luney112/touch-controller-v2/README.md

# touch-controller-v2

Version 2 of my touch controller for chunithm.

## TODO

- [ ] Finish firmware
- [ ] Test fully
- [ ] Write out docs and assembly instructions
