luney112/touch-controller-v2/cad/bambu.3mf

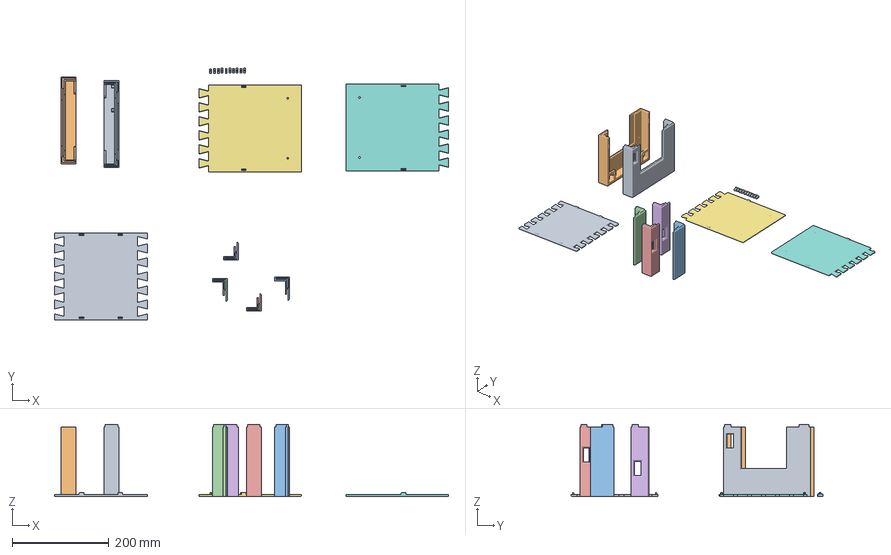
[picture p1: CAD file, 2025-06-15]
cad/bambu.3mf
815.8 x 521.4 x 149.2 mm
ShellRight
ShellLeft
ShellBottomCenterLeft
ShellBottomCenterRight
ShellTopCenterRight
ShellTopCenterLeft
BackPlateLeft
BackPlateRight
BackPlateCenter
LeftHold x 5
RightHold x 5
