luney112/touch-controller-v2/lasercut/glass.dxf

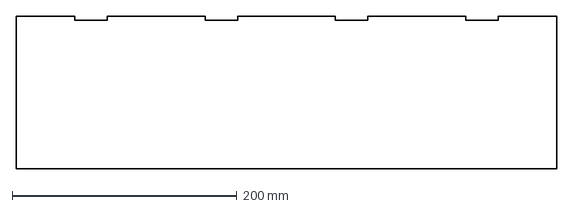
[picture p2: CAD file, 2025-06-01]
lasercut/glass.dxf
481.0 x 136.0 mm
