luney112/touch-controller-v2/cad/Controller3 v68.3mf

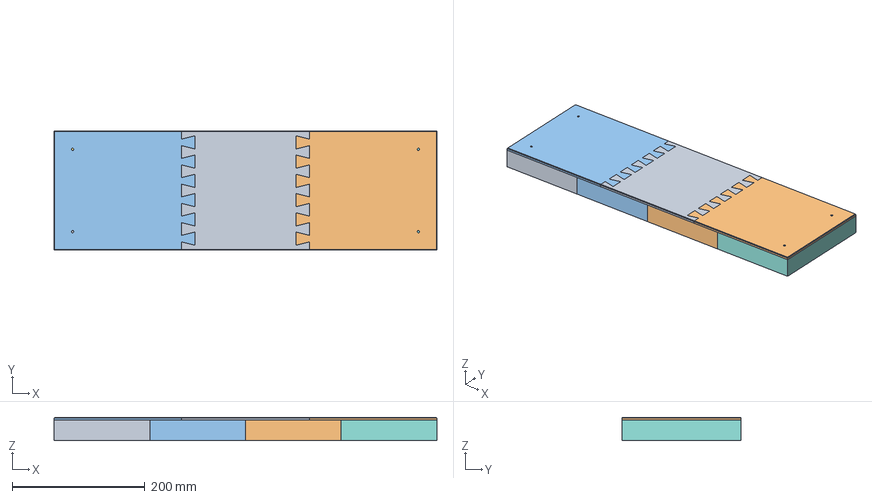
[picture p3: CAD file, 2025-06-14]
cad/Controller3 v68.3mf
577.0 x 180.0 x 35.0 mm
BackPlateCenter
BackPlateLeft
BackPlateRight
FrontGlass
KeysLeft
KeysRight
LeftHold
Mainboard
PcbLeft
PcbLeftCenter
PcbRight
PcbRightCenter
RightHold
Sensor
ShellBottomCenterLeft
ShellBottomCenterRight
ShellLeft
ShellRight
ShellTopCenterLeft
ShellTopCenterRight
