luney112/touch-controller-v2/lasercut/keys.dxf

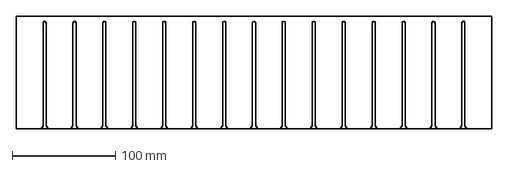
[picture p4: CAD file, 2025-06-01]
lasercut/keys.dxf
461.0 x 109.0 mm
