luney112/touch-controller-v2/(list of files, cad)

Other CAD files:
cad/Controller3 v68.f3d
