luney112/touch-controller-v2/kicad/touch-pads/touch-pads.kicad_pcb

## KiCad design kicad/touch-pads/touch-pads.kicad_pcb (2025-05-29)

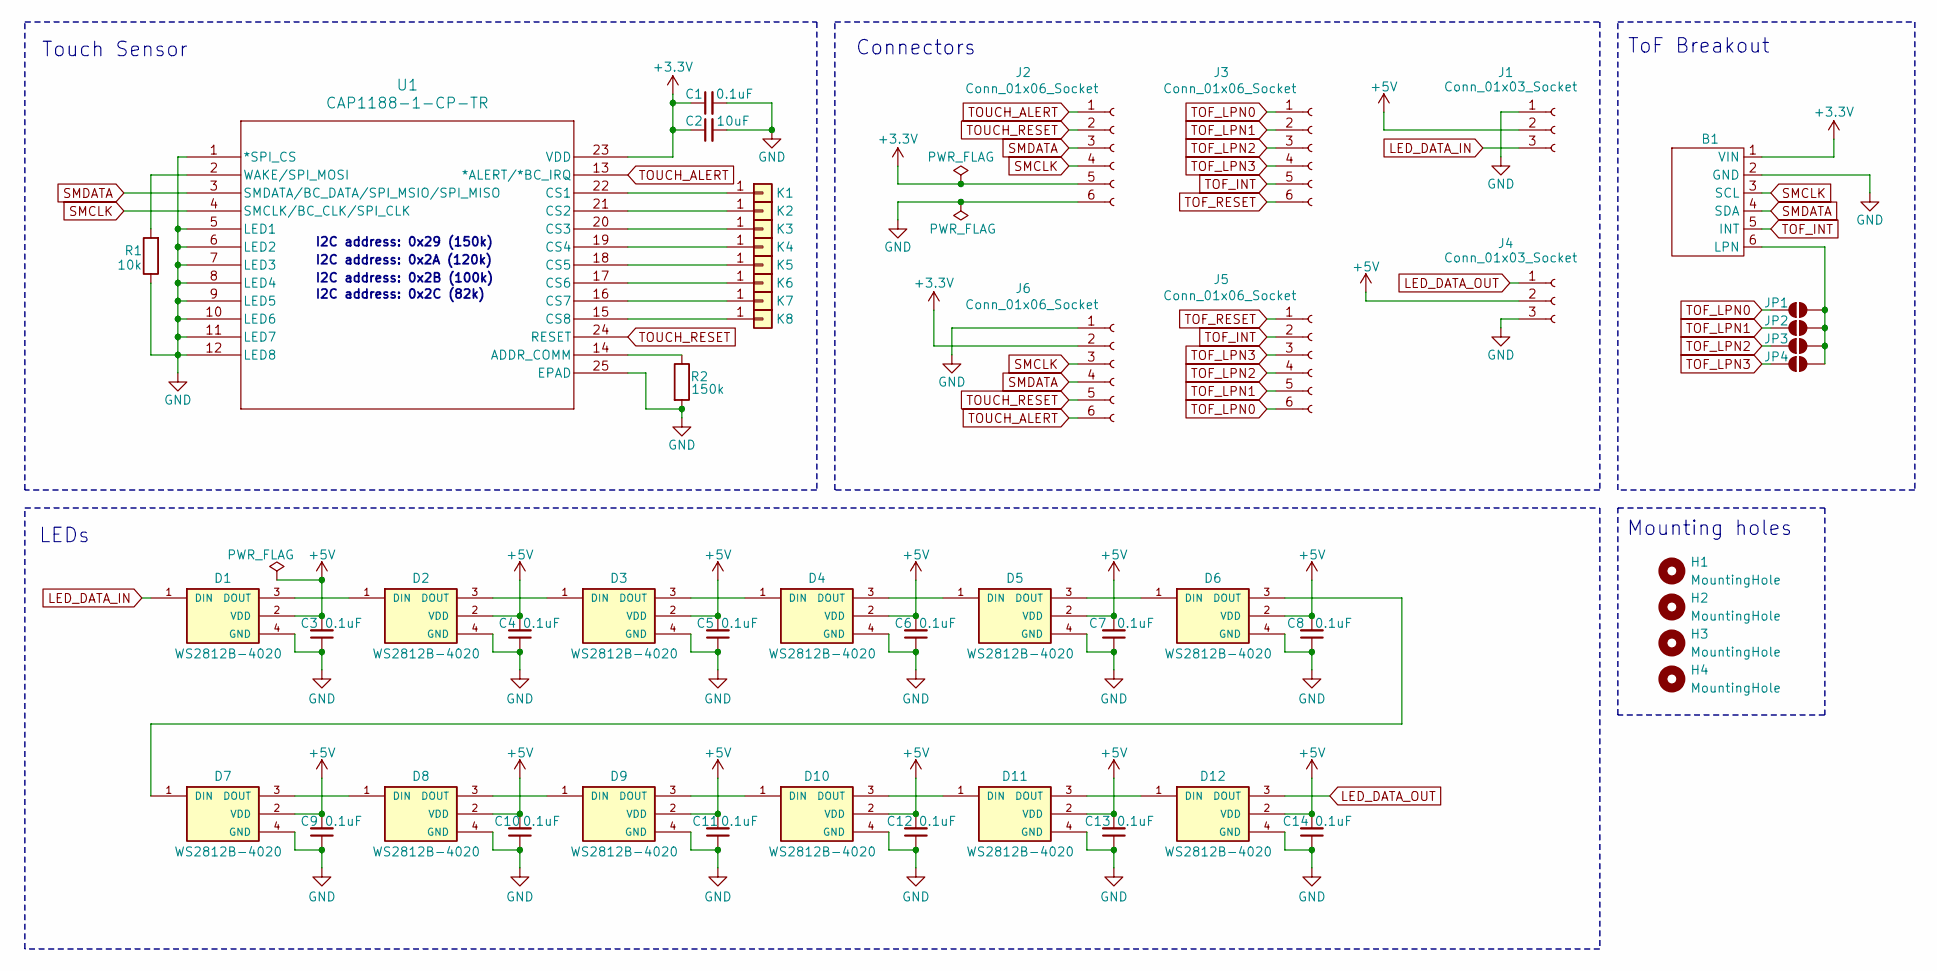
[picture p5: schematic touch-pads.kicad_sch]

Parts:
B1: VL53L5CX_Breakout_Aliexpress
C1, C3, C4, C5, C6, C7, C8, C9, C10, C11, C12, C13, C14: 0.1uF; C_0805_2012Metric_Pad1.18x1.45mm_HandSolder
C2: 10uF; C_0805_2012Metric_Pad1.18x1.45mm_HandSolder
D1, D2, D3, D4, D5, D6, D7, D8, D9, D10, D11, D12: WS2812B-4020; LED_WS2812B-4020; PARTREV V1.2
H1, H2, H3, H4: MountingHole; MountingHole_3.2mm_M3
J1, J4: Conn_01x03_Socket; JST_PH_S3B-PH-SM4-TB_1x03-1MP_P2.00mm_Horizontal
J2, J3, J5, J6: Conn_01x06_Socket; JST_GH_SM06B-GHS-TB_1x06-1MP_P1.25mm_Horizontal
JP1, JP2, JP3, JP4: SolderJumper_2_Open; SolderJumper-2_P1.3mm_Open_RoundedPad1.0x1.5mm
K1, K2, K3, K4, K5, K6, K7, K8: Conn_01x01; TouchKey_Standard
R1: 10k; R_0805_2012Metric_Pad1.20x1.40mm_HandSolder
R2: 150k; R_0805_2012Metric_Pad1.20x1.40mm_HandSolder
U1: CAP1188-1-CP-TR; QFN24_4X4MC_MCH

Connections:
+3.3V: B1.1 (VIN), C1.1, C2.1, J2.5, J6.2, U1.23 (VDD)
+5V: C3.2, C4.2, C5.2, C6.2, C7.2, C8.2, C9.2, C10.2, C11.2, C12.2, C13.2, C14.2, D1.2 (VDD), D2.2 (VDD), D3.2 (VDD), D4.2 (VDD), D5.2 (VDD), D6.2 (VDD), D7.2 (VDD), D8.2 (VDD), D9.2 (VDD), D10.2 (VDD), D11.2 (VDD), D12.2 (VDD), J1.2, J4.2
GND: B1.2 (GND), C1.2, C2.2, C3.1, C4.1, C5.1, C6.1, C7.1, C8.1, C9.1, C10.1, C11.1, C12.1, C13.1, C14.1, D1.4 (GND), D2.4 (GND), D3.4 (GND), D4.4 (GND), D5.4 (GND), D6.4 (GND), D7.4 (GND), D8.4 (GND), D9.4 (GND), D10.4 (GND), D11.4 (GND), D12.4 (GND), J1.1, J2.6, J4.3, J6.1, R1.1, R2.2, U1.1 (*SPI_CS), U1.5 (LED1), U1.6 (LED2), U1.7 (LED3), U1.8 (LED4), U1.9 (LED5), U1.10 (LED6), U1.11 (LED7), U1.12 (LED8), U1.25 (EPAD)
LED_DATA_IN: D1.1 (DIN), J1.3
LED_DATA_OUT: D12.3 (DOUT), J4.1
unnamed: B1.6 (LPN), JP1.2 (B), JP2.2 (B), JP3.2 (B), JP4.2 (B)
unnamed: D1.3 (DOUT), D2.1 (DIN)
unnamed: D2.3 (DOUT), D3.1 (DIN)
unnamed: D3.3 (DOUT), D4.1 (DIN)
unnamed: D4.3 (DOUT), D5.1 (DIN)
unnamed: D5.3 (DOUT), D6.1 (DIN)
unnamed: D6.3 (DOUT), D7.1 (DIN)
unnamed: D7.3 (DOUT), D8.1 (DIN)
unnamed: D8.3 (DOUT), D9.1 (DIN)
unnamed: D9.3 (DOUT), D10.1 (DIN)
unnamed: D10.3 (DOUT), D11.1 (DIN)
unnamed: D11.3 (DOUT), D12.1 (DIN)
unnamed: K1.1, U1.22 (CS1)
unnamed: K2.1, U1.21 (CS2)
unnamed: K3.1, U1.20 (CS3)
unnamed: K4.1, U1.19 (CS4)
unnamed: K5.1, U1.18 (CS5)
unnamed: K6.1, U1.17 (CS6)
unnamed: K7.1, U1.16 (CS7)
unnamed: K8.1, U1.15 (CS8)
unnamed: R2.1, U1.14 (ADDR_COMM)
unnamed: R1.2, U1.2 (WAKE/SPI_MOSI)
SMCLK: B1.3 (SCL), J2.4, J6.3, U1.4 (SMCLK/BC_CLK/SPI_CLK)
SMDATA: B1.4 (SDA), J2.3, J6.4, U1.3 (SMDATA/BC_DATA/SPI_MSIO/SPI_MISO)
TOF_INT: B1.5 (INT), J3.5, J5.2
TOF_LPN0: J3.1, J5.6, JP1.1 (A)
TOF_LPN1: J3.2, J5.5, JP2.1 (A)
TOF_LPN2: J3.3, J5.4, JP3.1 (A)
TOF_LPN3: J3.4, J5.3, JP4.1 (A)
TOF_RESET: J3.6, J5.1
TOUCH_ALERT: J2.1, J6.6, U1.13 (*ALERT/*BC_IRQ)
TOUCH_RESET: J2.2, J6.5, U1.24 (RESET)

Notes on the sheet:
ToF Breakout
I2C address: 0x2B (100k)
I2C address: 0x29 (150k)
LEDs
Mounting holes
Touch Sensor
Connectors
I2C address: 0x2C (82k)
I2C address: 0x2A (120k)

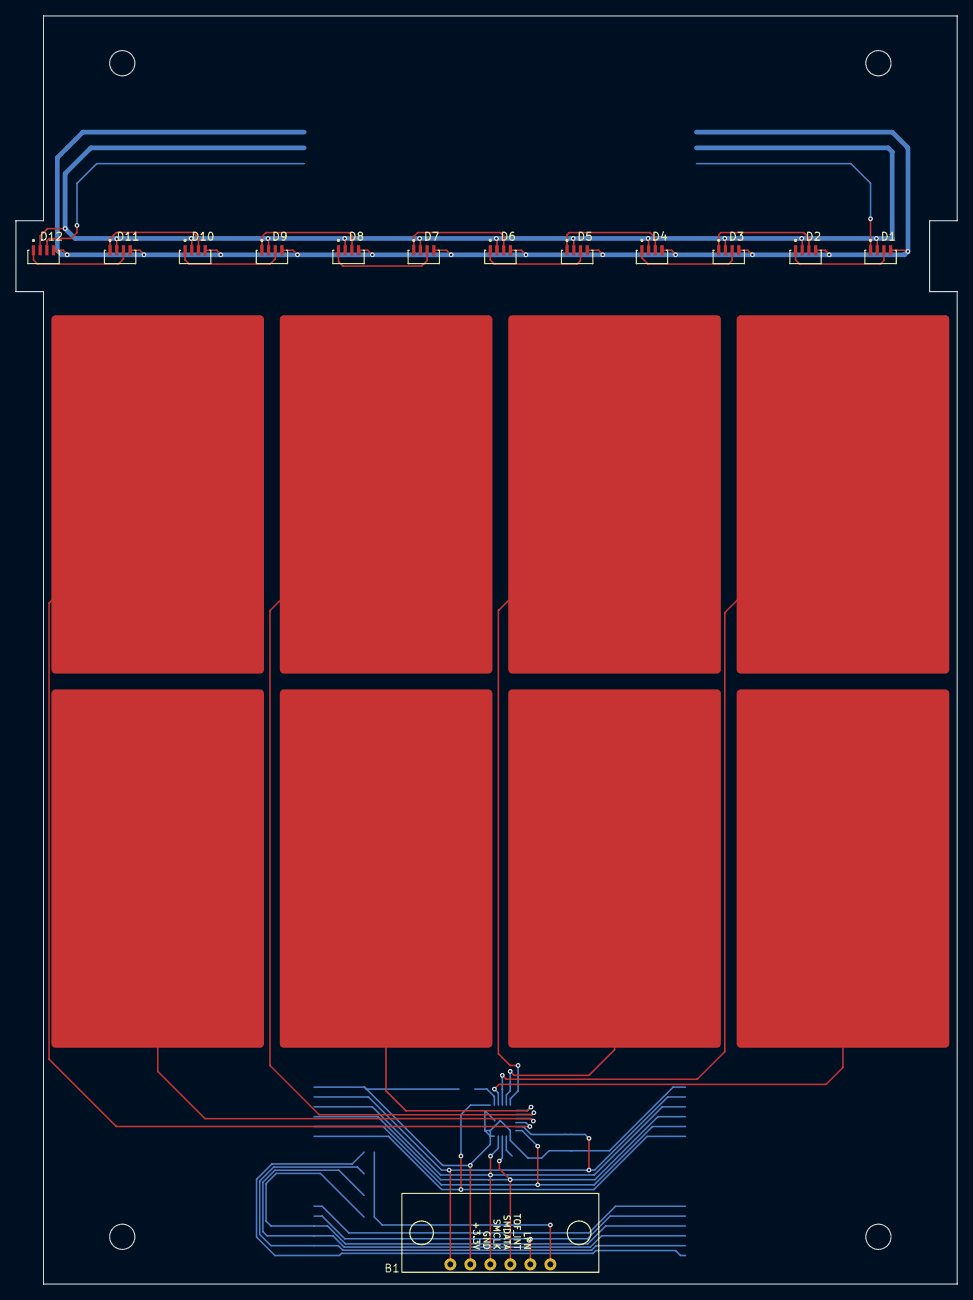
[picture p6: board touch-pads.kicad_pcb from above]

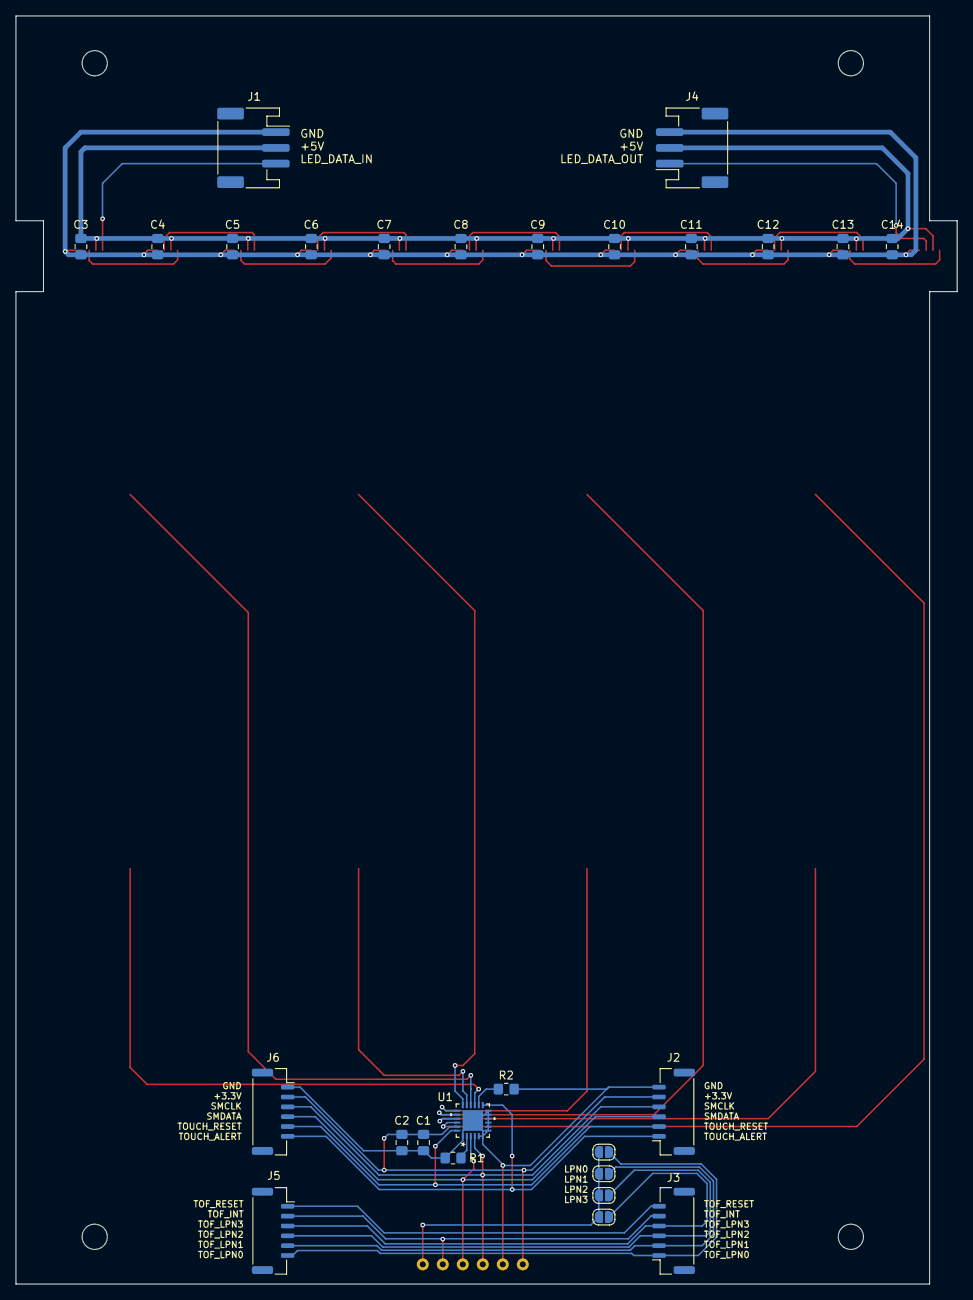
[picture p7: board touch-pads.kicad_pcb from below]

Board: 2 copper layers, 119.5 x 161.0 mm, 52 parts (27 on the bottom side), 37 nets.
