luney112/touch-controller-v2/kicad/mainboard/mainboard.kicad_pcb

## KiCad design kicad/mainboard/mainboard.kicad_pcb (2025-05-29)

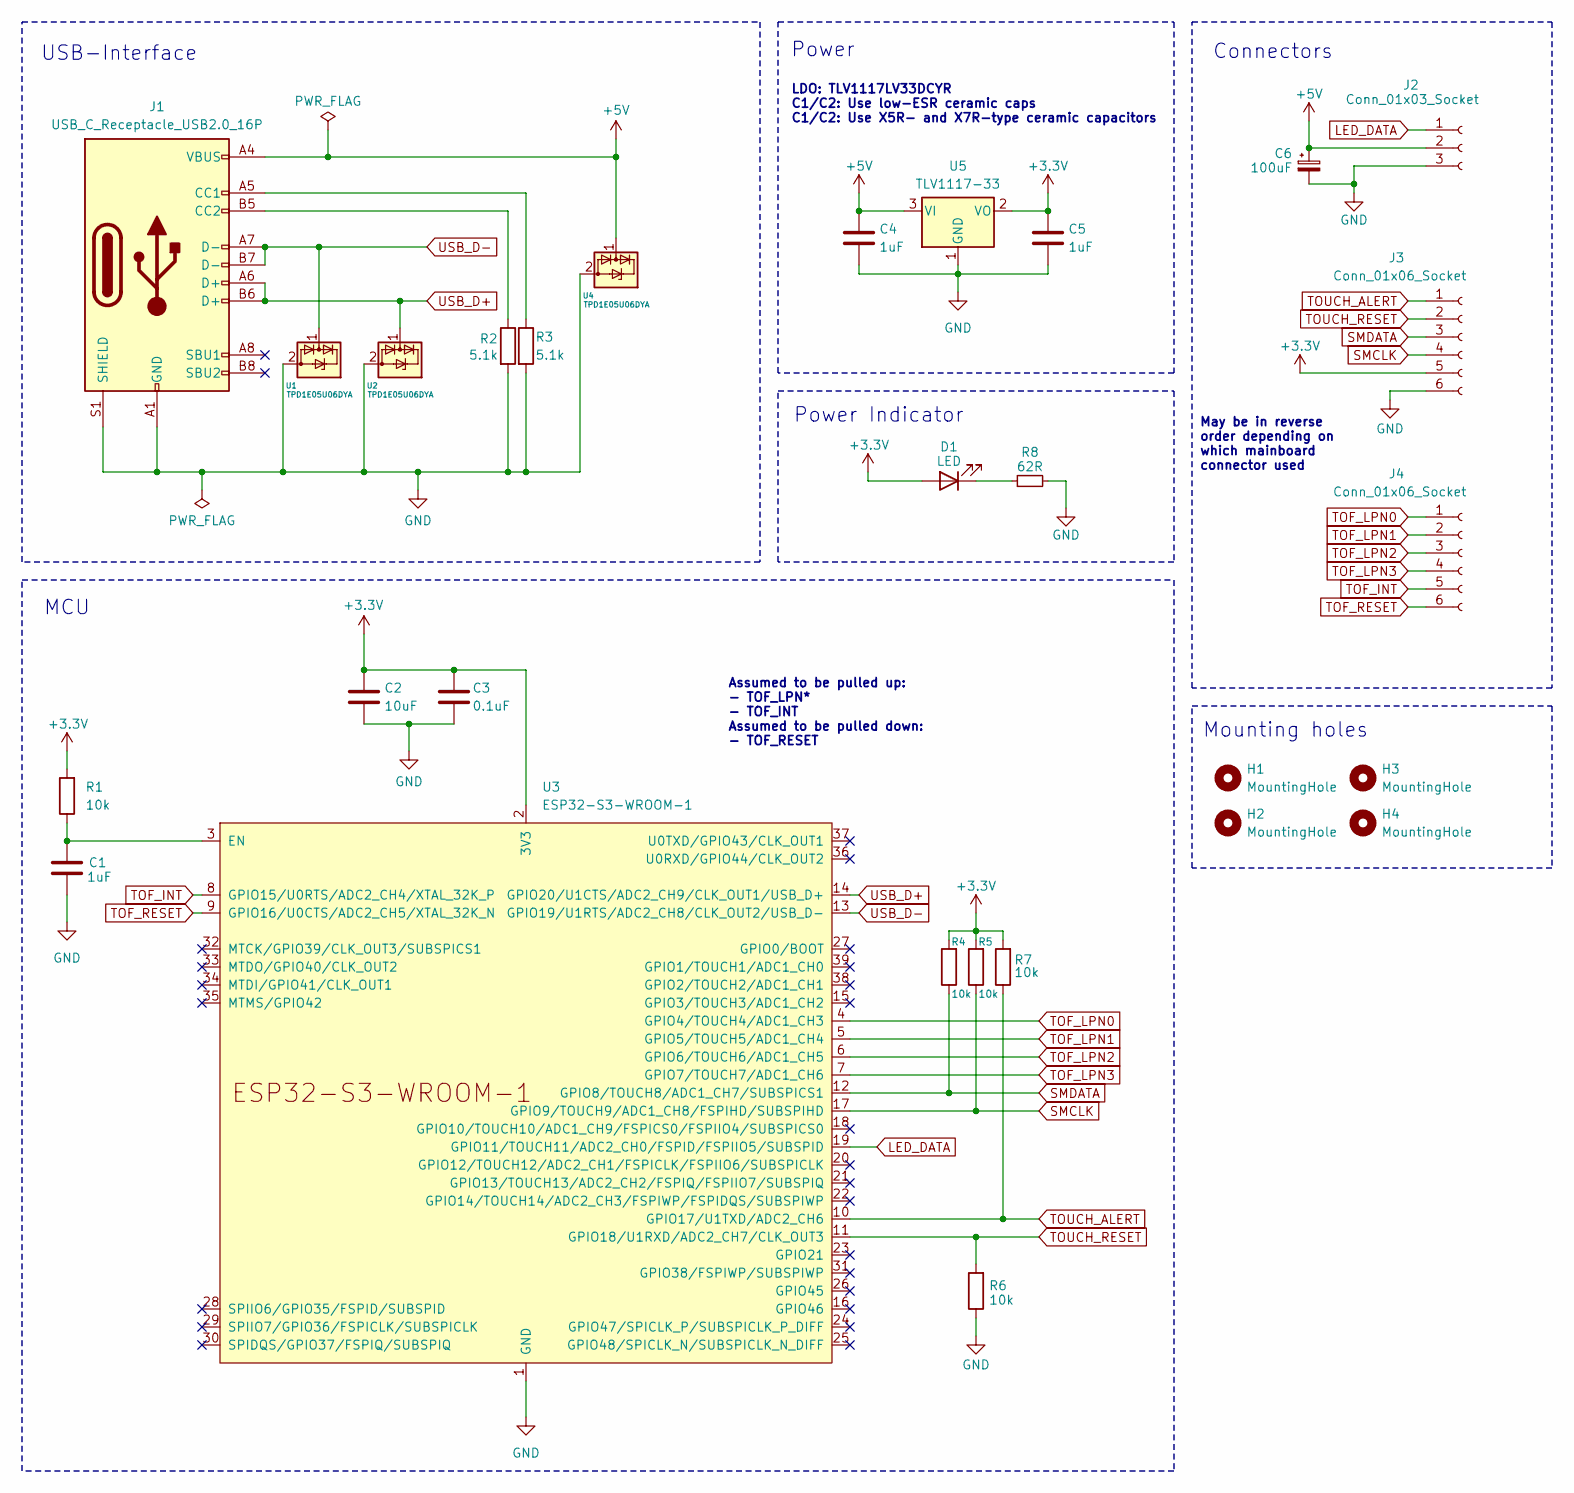
[picture p8: schematic mainboard.kicad_sch]

Parts:
C1, C4, C5: 1uF; C_0805_2012Metric_Pad1.18x1.45mm_HandSolder
C2: 10uF; C_0805_2012Metric_Pad1.18x1.45mm_HandSolder
C3: 0.1uF; C_0805_2012Metric_Pad1.18x1.45mm_HandSolder
C6: 100uF; CP_Elec_6.3x5.8
D1: LED; LED_0805_2012Metric_Pad1.15x1.40mm_HandSolder
H1, H2, H3, H4: MountingHole; MountingHole_2.2mm_M2
J1: USB_C_Receptacle_USB2.0_16P; USB_C_Receptacle_GCT_USB4105-xx-A_16P_TopMnt_Horizontal
J2: Conn_01x03_Socket; JST_PH_S3B-PH-SM4-TB_1x03-1MP_P2.00mm_Horizontal
J3, J4: Conn_01x06_Socket; JST_GH_SM06B-GHS-TB_1x06-1MP_P1.25mm_Horizontal
R1, R4, R5, R6, R7: 10k; R_0805_2012Metric_Pad1.20x1.40mm_HandSolder
R2, R3: 5.1k; R_0805_2012Metric_Pad1.20x1.40mm_HandSolder
R8: 62R; R_0805_2012Metric_Pad1.20x1.40mm_HandSolder
U1, U2, U4: TPD1E05U06DYA; D_SOD-523
U3: ESP32-S3-WROOM-1
U5: TLV1117-33; SOT-223-3_TabPin2

Connections:
+3.3V: C2.2, C3.2, C5.1, D1.2 (A), J3.5, R1.2, R4.2, R5.2, R7.2, U3.2 (3V3), U5.2 (VO)
+5V: C4.1, C6.1, J1.A4 (VBUS), J1.A9 (VBUS), J1.B4 (VBUS), J1.B9 (VBUS), J2.2, U4.1 (I/O), U5.3 (VI)
GND: C1.2, C2.1, C3.1, C4.2, C5.2, C6.2, J1.A1 (GND), J1.A12 (GND), J1.B1 (GND), J1.B12 (GND), J1.S1 (SHIELD), J2.3, J3.6, R2.2, R3.2, R6.1, R8.2, U1.2 (GND), U2.2 (GND), U3.1 (GND), U3.40 (GND), U3.41 (GND), U4.2 (GND), U5.1 (GND)
LED_DATA: J2.1, U3.19 (GPIO11/TOUCH11/ADC2_CH0/FSPID/FSPIIO5/S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)
unnamed: D1.1 (K), R8.1
unnamed: J1.A5 (CC1), R3.1
unnamed: J1.B5 (CC2), R2.1
unnamed: C1.1, R1.1, U3.3 (EN)
SMCLK: J3.4, R5.1, U3.17 (GPIO9/TOUCH9/ADC1_CH8/FSPIHD/SUBSPIHD)
SMDATA: J3.3, R4.1, U3.12 (GPIO8/TOUCH8/ADC1_CH7/SUBSPICS1)
TOF_INT: J4.5, U3.8 (GPIO15/U0RTS/ADC2_CH4/XTAL_32K_P)
TOF_LPN0: J4.1, U3.4 (GPIO4/TOUCH4/ADC1_CH3)
TOF_LPN1: J4.2, U3.5 (GPIO5/TOUCH5/ADC1_CH4)
TOF_LPN2: J4.3, U3.6 (GPIO6/TOUCH6/ADC1_CH5)
TOF_LPN3: J4.4, U3.7 (GPIO7/TOUCH7/ADC1_CH6)
TOF_RESET: J4.6, U3.9 (GPIO16/U0CTS/ADC2_CH5/XTAL_32K_N)
TOUCH_ALERT: J3.1, R7.1, U3.10 (GPIO17/U1TXD/ADC2_CH6)
TOUCH_RESET: J3.2, R6.2, U3.11 (GPIO18/U1RXD/ADC2_CH7/CLK_OUT3)
USB_D+: J1.A6 (D+), J1.B6 (D+), U2.1 (I/O), U3.14 (GPIO20/U1CTS/ADC2_CH9/CLK_OUT1/USB_D+)
USB_D-: J1.A7 (D-), J1.B7 (D-), U1.1 (I/O), U3.13 (GPIO19/U1RTS/ADC2_CH8/CLK_OUT2/USB_D-)

Notes on the sheet:
Assumed to be pulled up: - TOF_LPN* - TOF_INT Assumed to be pulled down: - TOF_RESET
May be in reverse order depending on which mainboard connector used
Power Indicator
Connectors
MCU
LDO: TLV1117LV33DCYR C1/C2: Use low-ESR ceramic caps C1/C2: Use X5R- and X7R-type ceramic capacitors
Mounting holes
USB-Interface
Power

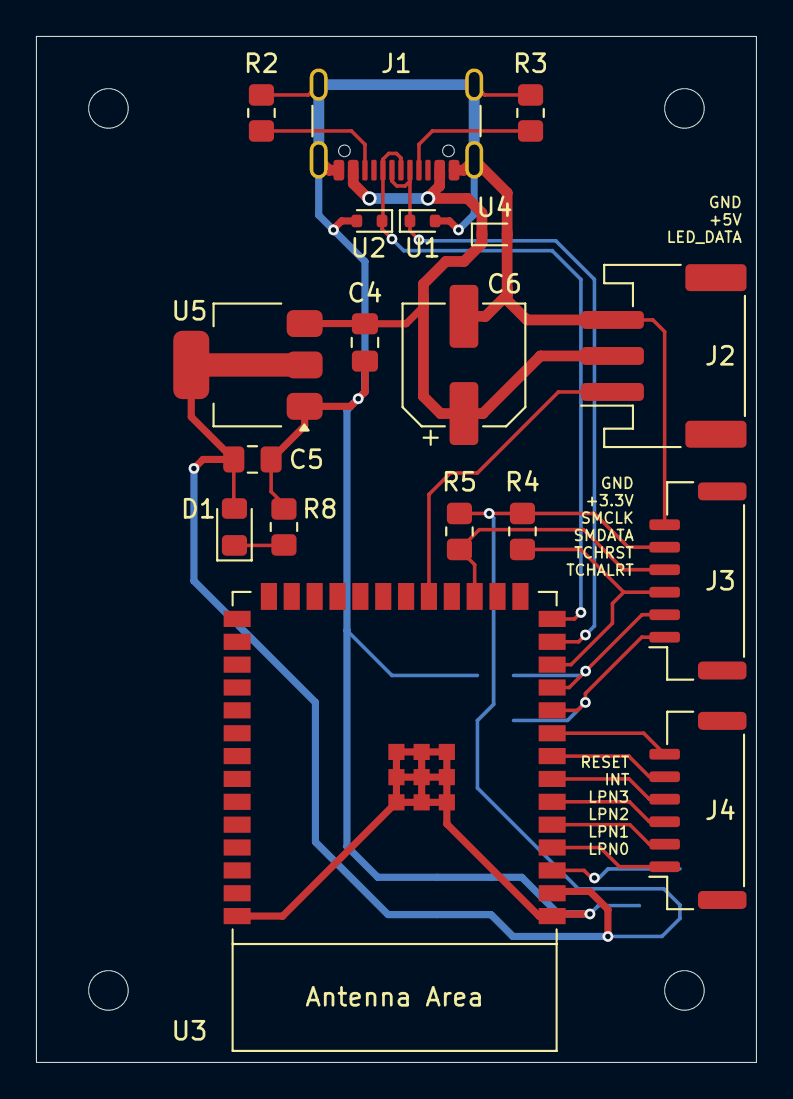
[picture p9: board mainboard.kicad_pcb from above]

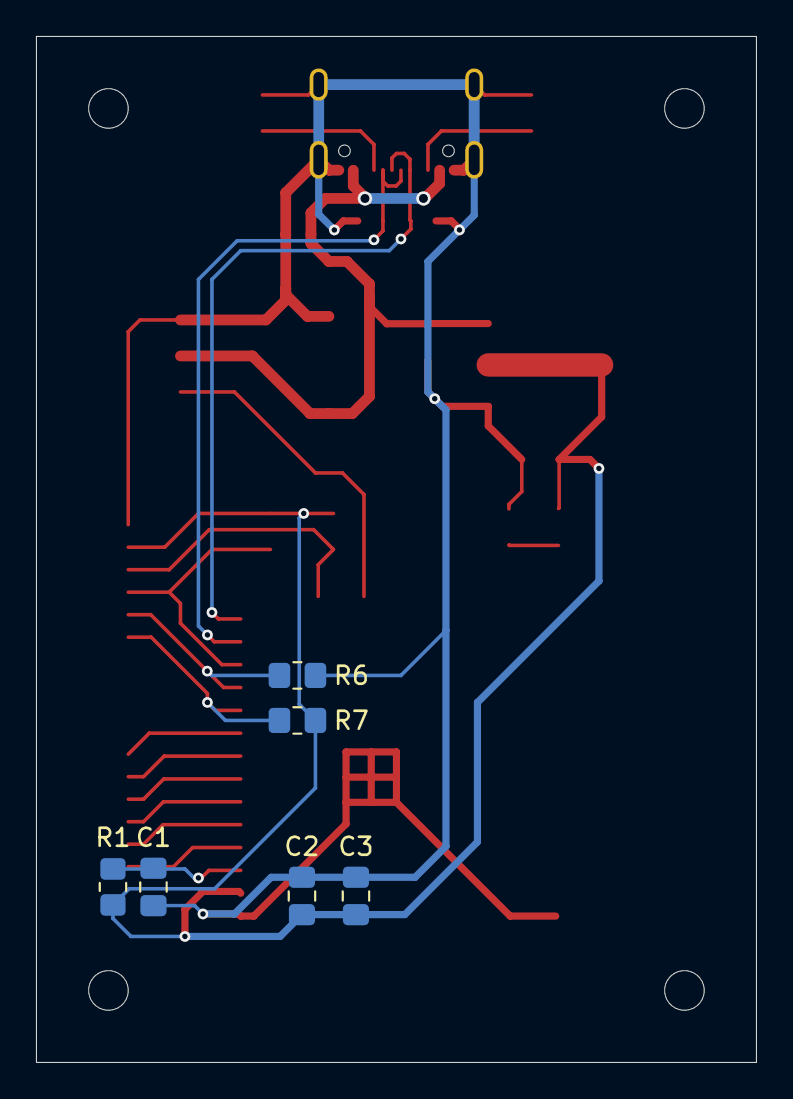
[picture p10: board mainboard.kicad_pcb from below]

Board: 2 copper layers, 40.0 x 57.0 mm, 28 parts (6 on the bottom side), 20 nets.
