luney112/touch-controller-v2/firmware/touch-controller/src/air.cpp

/**
 * Some good reference material:
 *  https://www.st.com/resource/en/datasheet/vl53l5cx.pdf
 *  https://www.pololu.com/file/0J1885/um2884-a-guide-to-using-the-vl53l5cx-multizone-timeofflight-ranging-sensor-with-wide-field-of-view-ultra-lite-driver-uld-stmicroel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
 *  https://community.st.com/t5/imaging-sensors/vl53l8cx-example-quot-platform-h-quot-ram-reduction/td-p/714296
 *  https://github.com/sparkfun/SparkFun_VL53L5CX_Arduino_Library/tree/main/examples
 *
 * Things to tune:
 *  - Resolution
 *  - Ranging frequency
 *  - Search zones
 *  - Search zones hit requirement
 *  - Sharpener
 *  - Target status
 */
#include "air.h"
#include "layout.h"
#include "serial.h"
#include <Arduino.h>
#include <SparkFun_VL53L5CX_Library.h>

// 4x4 mode has a lower resolution, but can run at 60hz. It also has a lower average latency (5ms)
// 8x8 mode has a higher resolution, but can only run at 15hz. It has a higher average latency (14ms)
// For now, use 4x4 mode since we care most about responsiveness and accuracy (having a poll rate)
#define USE_4X4

constexpr uint8_t AddressMap[] = {TOF_ADDR_0, TOF_ADDR_1, TOF_ADDR_2, TOF_ADDR_3};
constexpr uint8_t LpnMap[] = {GPIO_TOF_LPN0, GPIO_TOF_LPN1, GPIO_TOF_LPN2, GPIO_TOF_LPN3};

#ifdef USE_4X4
constexpr uint8_t Resolution = VL53L5CX_RESOLUTION_4X4;
constexpr uint8_t RangingFrequency = 60; // Max 60hz for 4x4, 15hz for 8x8
#else
constexpr uint8_t Resolution = VL53L5CX_RESOLUTION_8X8;
constexpr uint8_t RangingFrequency = 15; // Max 60hz for 4x4, 15hz for 8x8
#endif

constexpr unsigned long RangingFrequencyIntervalMillis = 1000 / RangingFrequency;

// Zones we care about for distance measurement. Right now, just the middle-back ones
#ifdef USE_4X4
constexpr uint8_t SearchZones[] = {9, 10, 13, 14};
// The number of zones that must be hit for a specific band to be considered hit
constexpr uint8_t SearchZonesHitRequirement = 1;
#else
constexpr uint8_t SearchZones[] = {25, 26, 27, 28, 29, 30, 33, 34, 35, 36, 37, 38};
// The number of zones that must be hit for a specific band to be considered hit
constexpr uint8_t SearchZonesHitRequirement = 2;
#endif
constexpr uint8_t SearchZonesCount = sizeof(SearchZones) / sizeof(SearchZones[0]);

constexpr uint16_t BandCount = 6;
constexpr uint16_t SingleBandSizeMm = 23;
constexpr uint16_t LowBarMm = 10.0 * 10; // 10cm
constexpr uint16_t HighBarMm = LowBarMm + BandCount * SingleBandSizeMm;

// Max speed is 1MHz
constexpr uint32_t MaxWireClockSpeed = 1000000;

volatile int AirController::interruptCount;

// This function puts the ToF sensors in a disabled state
// No communication or setup should be done with the sensors
bool AirController::begin(SerialController *serial) {
  this->serial = serial;

  memset(measurementData, 0, sizeof(measurementData));

  // Disable all ToF sensors
  for (int i = 0; i < TofCount; i++) {
    pinMode(LpnMap[i], OUTPUT);
    digitalWrite(LpnMap[i], LOW);
  }
  delay(50);

  return true;
}

// Setup and initialize the ToF sensors
bool AirController::init() {
  /*
    At each power on reset, a staggering 86,000 bytes of firmware have to be sent to the sensor.
    At 100kHz, this can take ~9.4s. By increasing the clock speed, we can cut this time down to ~1.4s.

    Two parameters can be tweaked:

      Clock speed: The VL53L5CX has a max bus speed of 1MHz.

      Max transfer size: The majority of Arduino platforms default to 32 bytes. If you are using one
      with a larger buffer (ESP32 is 128 bytes for example), this can help decrease transfer times a bit.

    https://github.com/sparkfun/SparkFun_VL53L5CX_Arduino_Library/blob/main/examples/Example2_FastStartup/Example2_FastStartup.ino

    ---

    The issue is that CAP1188 has a max speed of 400kHz.
    So only use 1MHz for firmware transfer, then reset it back to what it was before
  */
  const uint32_t currentWireClock = Wire.getClock();
  Wire.setClock(MaxWireClockSpeed);
  delay(50);

  // Re-write i2c addresses
  // 1. Disable i2c for all sensors
  // 2. For every sensor:
  //      a) Enable i2c and initialize
  //      b) Write new address
  //      c) Disable i2c
  // 3. Re-enable i2c for all sensors

  // 1. Disable all ToF sensors
  for (int i = 0; i < TofCount; i++) {
    digitalWrite(LpnMap[i], LOW);
  }
  delay(50);

  // 2. Change addresses one-by-one
  for (int i = 0; i < TofCount; i++) {
    // Enable i2c
    digitalWrite(LpnMap[i], HIGH);
    delay(50);

    // Call begin() using the default address
    // All other i2c devices that could interfere should be disabled
    if (!sensors[i].begin()) {
      // Try again, but use the desired address
      // This can happen if power was not cut off to the sensor, but the processor was reset/rebooted
      // e.g. during development. This should not happen normally.
      // If we ever have a reset pin that works properly, we can use that to also fully reset the sensor
      if (!sensors[i].begin(AddressMap[i])) {
        serial
            ->writeDebugLogf("[ERROR] Unable to initialize ToF %#02X: %d", AddressMap[i],
                             sensors[i].lastError.lastErrorCode)
            ->processWrite();
        return false;
      }
    }
    delay(50);

    // Set the new address
    sensors[i].setAddress(AddressMap[i]);

    // Increase default from 32 bytes to 128 - not supported on all platforms
    // Must be called after begin() to prevent a segfault
    sensors[i].setWireMaxPacketSize(128);

    // Disable i2c
    digitalWrite(LpnMap[i], LOW);
    delay(50);
  }

  // 3. Re-enable all devices
  for (int i = 0; i < TofCount; i++) {
    digitalWrite(LpnMap[i], HIGH);
  }
  delay(50);

  // Setup interupt
  pinMode(GPIO_TOF_INT, INPUT_PULLUP);
  attachInterrupt(GPIO_TOF_INT, interruptFn, FALLING);

  for (int i = 0; i < TofCount; i++) {
    sensors[i].setResolution(Resolution);
    sensors[i].setRangingFrequency(RangingFrequency);
    sensors[i].setRangingMode(SF_VL53L5CX_RANGING_MODE::CONTINUOUS);
    sensors[i].setTargetOrder(SF_VL53L5CX_TARGET_ORDER::STRONGEST);
    // sensors[i].setSharpenerPercent(40);
    sensors[i].startRanging();
    delay(50);
  }

  serial->writeDebugLog("Initialized ToFs")->processWrite();

  // Before finishing, set the clock speed back
  Wire.setClock(currentWireClock);
  delay(50);

  return true;
}

void AirController::loop() {
  // Not enough time has passed since the last range, skip
  if (millis() - lastRangeTimeMillis < RangingFrequencyIntervalMillis) {
    return;
  }

  if (interruptCount == 0) {
    return;
  }

  // Reset
  interruptCount = 0;
  lastRangeTimeMillis = millis();
  memset(measurementData, 0, sizeof(measurementData));

  // Set faster clock speed for reading data
  const uint32_t currentWireClock = Wire.getClock();
  Wire.setClock(MaxWireClockSpeed);

  for (int i = 0; i < TofCount; i++) {
    if (!sensors[i].getRangingData(&measurementData[i])) {
      serial->writeDebugLog("Could not get ranging data")->processWrite();
      continue;
    }
  }

  // After reading, set the clock speed back
  Wire.setClock(currentWireClock);

  uint8_t val = 0;

  // Now, calculate using the ranging data the blocked sensor value
  // For every sensor
  for (int i = 0; i < TofCount; i++) {
    uint8_t hitCountsPerBand[BandCount] = {0};
    auto data = &measurementData[i];
    // For each zone/pixel of the sensor
    for (int j = 0; j < SearchZonesCount; j++) {
      auto zid = SearchZones[j];
      // We must have at least one thing detected
      if (data->nb_target_detected[zid] == 0) {
        continue;
      }
      // We consider 5,6,9 as valid
      // TODO: Limit to only 5?
      auto status = data->target_status[zid];
      if (status == 5) {
        auto mm = data->distance_mm[zid];
        // Ignore distances outside of range
        if (mm < LowBarMm || mm >= HighBarMm) {
          continue;
        }
        uint16_t normalized = mm - LowBarMm;
        uint16_t pos = (normalized / SingleBandSizeMm); // pos will be 0-indexed (0 to BandCount - 1)
        if (pos >= BandCount) {                         // pos should be less than BandCount
          serial->writeDebugLogf("Detected invalid ToF band state: %dmm -> pos=%d", mm, pos);
          continue;
        }
        hitCountsPerBand[pos]++;
      }
    }

    for (int j = 0; j < BandCount; j++) {
      // If we have enough hits in this band, set the corresponding bit
      if (hitCountsPerBand[j] >= SearchZonesHitRequirement) {
        val |= (1 << j); // Set the bit corresponding to the band (0-indexed)
      }
    }
  }

  lastCalculatedSensorValue = val;
}

uint8_t AirController::getBlockedSensors() {
  return lastCalculatedSensorValue;
}
