luney112/touch-controller-v2/firmware/touch-controller/include/utils.h

#ifndef UTILS_H
#define UTILS_H

#include <cstdint>
#include <functional>

class LatencyTracker {
public:
  using MeasureFunc_t = std::function<void()>;
  using ResultCallback_t = std::function<void(uint32_t, uint32_t, uint32_t)>;

  LatencyTracker(uint32_t intervalMillis, bool includeZeroValues = true);

  void measureAndRecord(MeasureFunc_t measureFunc, ResultCallback_t resultCallback);

private:
  uint32_t intervalMillis = 0;
  bool includeZeroValues = true;

  unsigned long sum = 0;
  unsigned long count = 0;
  unsigned long startTimeMillis = 0;
};

void scan();

#endif
