luney112/touch-controller-v2/(commit log)

2024-12-03 small board
    [touch-pads.kicad_pcb, touch-pads.kicad_sch]
2024-12-04 large board
    [touch-pads.kicad_pcb, touch-pads.kicad_sch]
2024-12-04 more work
    [touch-pads.kicad_pcb]
2024-12-04 add bypass caps
    [touch-pads.kicad_pcb, touch-pads.kicad_sch]
2024-12-04 mounting holes on schematic
    [touch-pads.kicad_pcb, touch-pads.kicad_sch]
2024-12-04 split version
    [touch-pads.kicad_pcb, touch-pads.kicad_sch]
2024-12-05 tweaks to split
    [touch-pads.kicad_pcb, touch-pads.kicad_sch]
2024-12-05 angled jst
    [touch-pads.kicad_pcb, touch-pads.kicad_sch]
2024-12-05 add variant resistors
    [touch-pads.kicad_pcb, touch-pads.kicad_sch]
2024-12-05 update refs and tracks
    [touch-pads.kicad_pcb, touch-pads.kicad_sch]
2024-12-05 align between two pcbs
    [touch-pads.kicad_pcb]
2024-12-05 adjust text
    [touch-pads.kicad_pcb]
2024-12-05 organize files
    [touch-pads.kicad_pcb, touch-pads.kicad_sch]
2024-12-05 bom, update readme, move connector
    [touch-pads.kicad_pcb]
2024-12-06 mainboard v1
    [mainboard.kicad_pcb, mainboard.kicad_sch]
2024-12-06 mainboard pcb v1
    [mainboard.kicad_pcb, mainboard.kicad_sch]
2024-12-07 mainboard cleaned
    [mainboard.kicad_pcb, mainboard.kicad_sch]
2024-12-08 more cleanup
    [mainboard.kicad_pcb]
2024-12-08 via/trace cleanup, larger via for 5v2a
    [mainboard.kicad_pcb]
2024-12-08 adjust edge cut
    [mainboard.kicad_pcb]
2024-12-08 Add logo
    [mainboard.kicad_pcb]
2024-12-08 fix erc
    [mainboard.kicad_pcb]
2024-12-08 add mountholes
    [mainboard.kicad_pcb, mainboard.kicad_sch]
2024-12-08 solder mask logo
    [mainboard.kicad_pcb]
2024-12-09 remove buttons
    [mainboard.kicad_pcb, mainboard.kicad_sch]
2024-12-09 move common lib, cleanup tracks, logo
    [touch-pads.kicad_pcb]
2024-12-13 update led
2024-12-27 Add some lasercut files stuff
    [glass.dxf, keys.dxf]
2025-01-05 fix board connectivity
2025-01-20 remove full-board version
    [touch-pads.kicad_pcb, touch-pads.kicad_sch]
2025-01-21 remove switches
    [mainboard.kicad_pcb, mainboard.kicad_sch]
2025-01-21 remove switch lib, add label for led connectors
    [mainboard.kicad_pcb]
2025-01-22 update touch pad
    [touch-pads.kicad_pcb, touch-pads.kicad_sch]
2025-01-22 fix some 3d models
    [touch-pads.kicad_pcb]
2025-01-23 fixup stuff
    [mainboard.kicad_pcb, mainboard.kicad_sch, touch-pads.kicad_pcb]
2025-01-23 mainboard gerber
    [mainboard-B_Cu.gbl, mainboard-B_Mask.gbs, mainboard-B_Paste.gbp, mainboard-B_Silkscreen.gbo, mainboard-Edge_Cuts.gm1, mainboard-F_Cu.gtl, mainboard-F_Mask.gts, mainboard-F_Paste.gtp]
2025-01-23 touch-pad gerber
    [touch-pads-B_Cu.gbl, touch-pads-B_Mask.gbs, touch-pads-B_Paste.gbp, touch-pads-B_Silkscreen.gbo, touch-pads-Edge_Cuts.gm1, touch-pads-F_Cu.gtl, touch-pads-F_Mask.gts, touch-pads-F_Paste.gtp]
2025-01-23 fix label
    [mainboard-B_Cu.gbl, mainboard-B_Mask.gbs, mainboard-B_Paste.gbp, mainboard-B_Silkscreen.gbo, mainboard-Edge_Cuts.gm1, mainboard-F_Cu.gtl, mainboard-F_Mask.gts, mainboard-F_Paste.gtp]
2025-01-23 Add pcb readme
2025-01-23 update lasercutting
    [glass.dxf, keys.dxf]
2025-01-27 v1 controller cad
    [controller.3mf, controller.f3d]
2025-02-05 fixes + bambu project
    [bambu.3mf, controller.3mf, controller.f3d]
2025-02-06 fix led type
2025-05-17 v3 mainboard with more tof sensors
    [mainboard.kicad_pcb, mainboard.kicad_sch]
2025-05-17 sync footprints or something
    [mainboard.kicad_pcb]
2025-05-18 v3 touchpads with Tof sensors
    [mainboard.kicad_pcb, touch-pads.kicad_pcb, touch-pads.kicad_sch]
2025-05-18 cleanup some
    [touch-pads.kicad_pcb]
2025-05-18 cap ordering
    [touch-pads.kicad_pcb]
2025-05-18 update to kicad 9
    [mainboard.kicad_pcb, mainboard.kicad_sch, touch-pads.kicad_pcb, touch-pads.kicad_sch]
2025-05-19 bom gerber readme
    [mainboard-B_Cu.gbl, mainboard-B_Mask.gbs, mainboard-B_Paste.gbp, mainboard-B_Silkscreen.gbo, mainboard-Edge_Cuts.gm1, mainboard-F_Cu.gtl, mainboard-F_Mask.gts, mainboard-F_Paste.gtp]
2025-05-25 update deps, add missing ret
    [cap1188.cpp]
2025-05-26 add mount holes
    [touch-pads.kicad_pcb, touch-pads.kicad_sch]
2025-05-26 re-route mainboard for better connectors
    [mainboard.kicad_pcb]
2025-05-26 change led to 11
    [mainboard.kicad_pcb, mainboard.kicad_sch]
2025-05-26 adjust breakout board to be more accurate
    [touch-pads.kicad_pcb]
2025-05-26 final tweaks
    [mainboard.kicad_pcb]
2025-05-27 route LDO after TVS
    [mainboard.kicad_pcb]
2025-05-27 fix breakout board
    [touch-pads.kicad_pcb]
2025-05-27 gerber and bom
    [mainboard-B_Cu.gbl, mainboard-B_Mask.gbs, mainboard-B_Paste.gbp, mainboard-B_Silkscreen.gbo, mainboard-Edge_Cuts.gm1, mainboard-F_Cu.gtl, mainboard-F_Mask.gts, mainboard-F_Paste.gtp]
2025-05-27 fix some jlpcb complaints
    [touch-pads.kicad_pcb]
2025-05-29 real final tweaks for now
    [mainboard-B_Cu.gbl, mainboard-B_Mask.gbs, mainboard-B_Paste.gbp, mainboard-B_Silkscreen.gbo, mainboard-Edge_Cuts.gm1, mainboard-F_Cu.gtl, mainboard-F_Mask.gts, mainboard-F_Paste.gtp]
2025-06-01 update lasercut
    [glass.dxf, keys.dxf]
2025-06-14 update cad
    [Controller3 v68.3mf, Controller3 v68.f3d, bambu.3mf, controller.3mf, controller.f3d]
2025-06-15 update bambu
    [bambu.3mf]
2025-06-25 led fixes
2025-06-28 led brightness to max
